vinn-ie/OPEN_ROCKET_TRACKER/Hardware/ORCA OPEN ROCKET TRACKER SCHEM.pdf

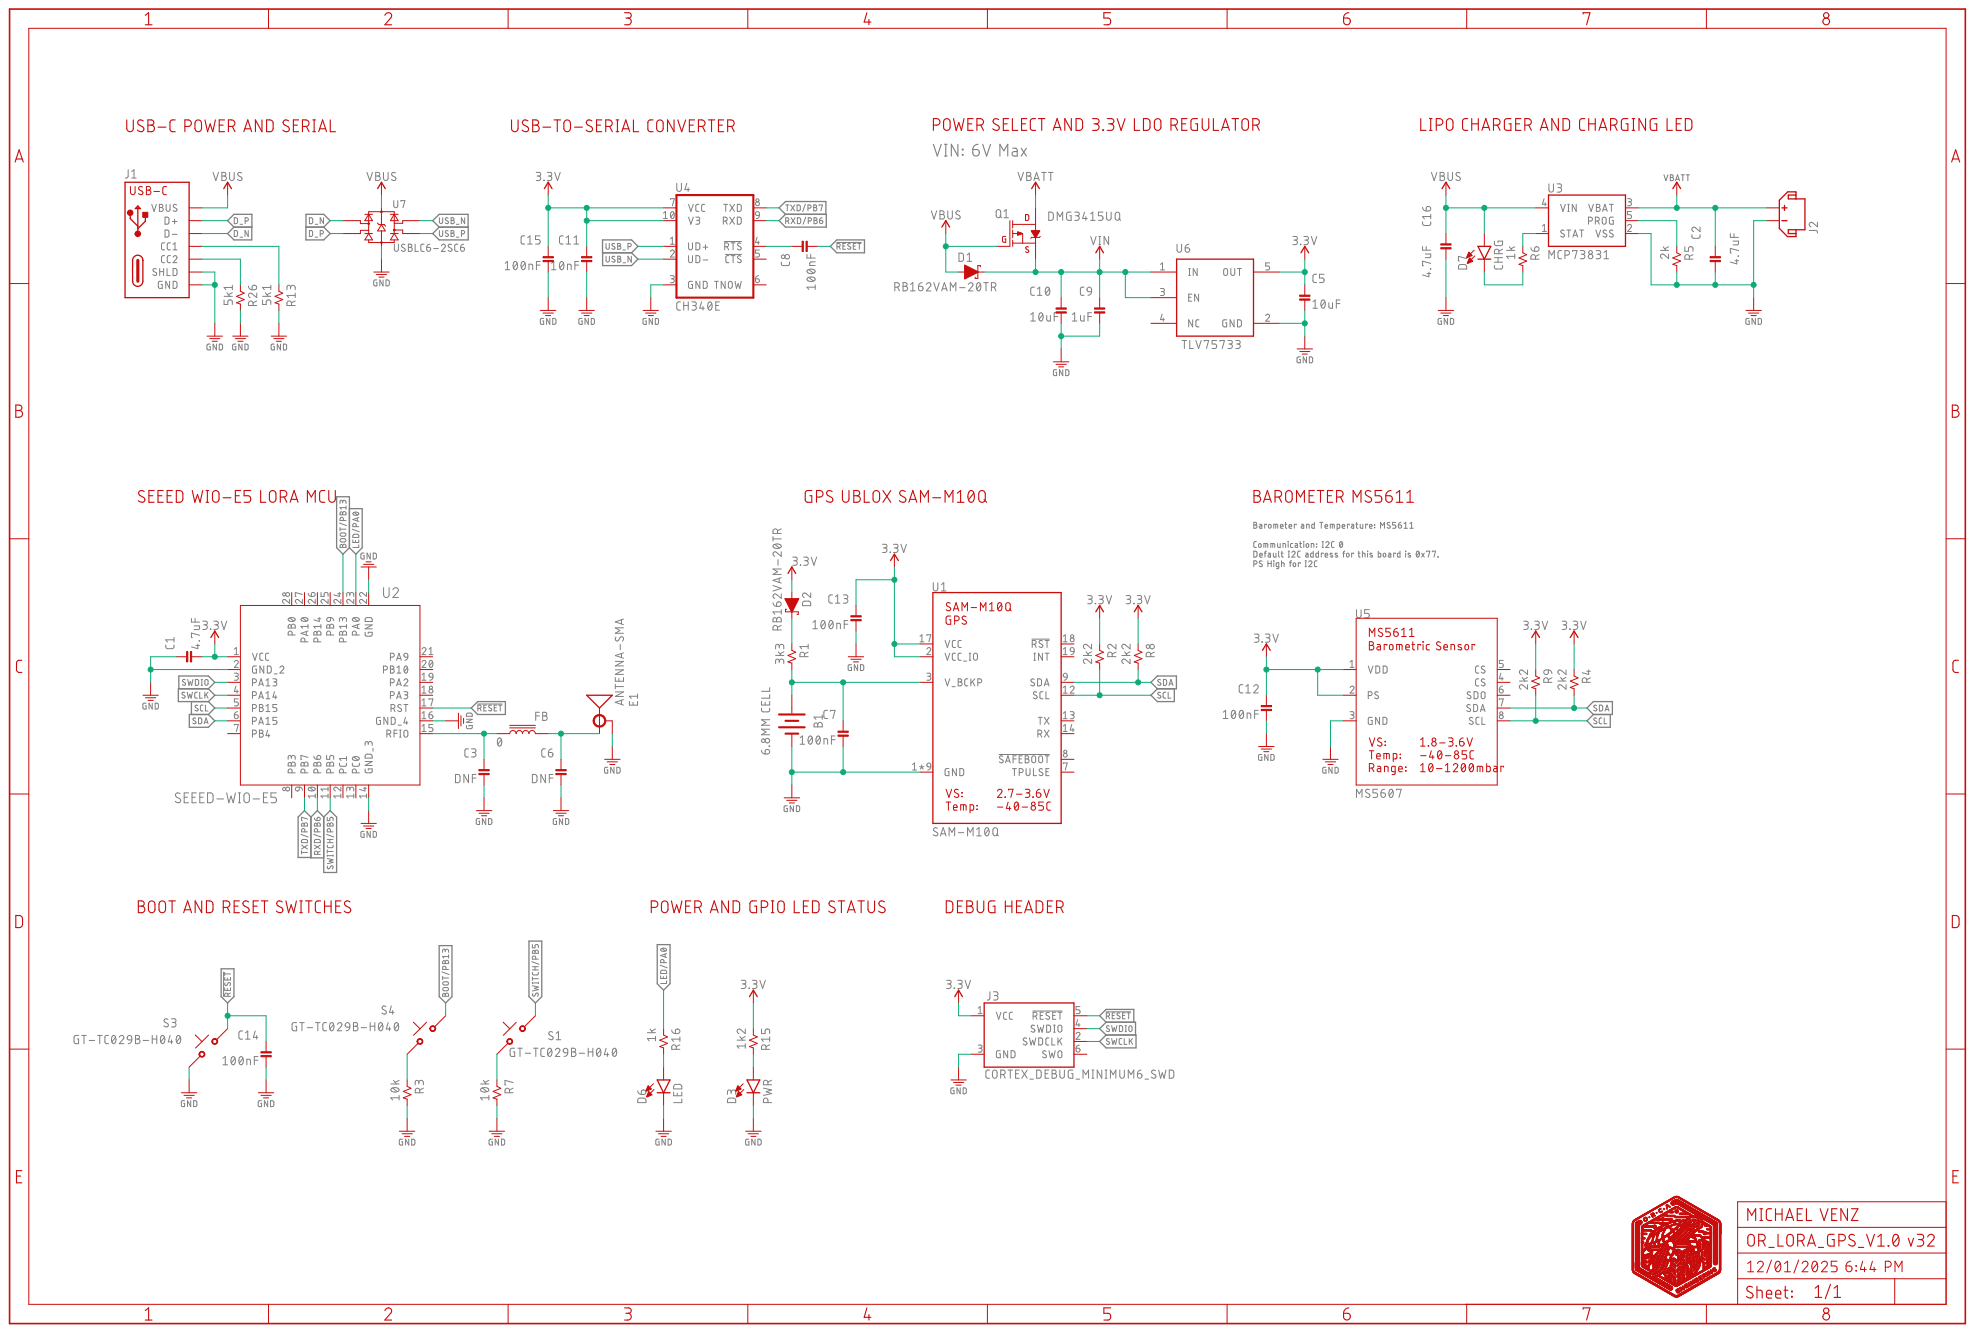
[picture p1: page 1]
